nivekg/prizm-switch-control/prizm-switch-control-v1_1/prizm-switch-control-v1_1.kicad_pcb

## KiCad design prizm-switch-control-v1_1/prizm-switch-control-v1_1.kicad_pcb (2020-03-06)

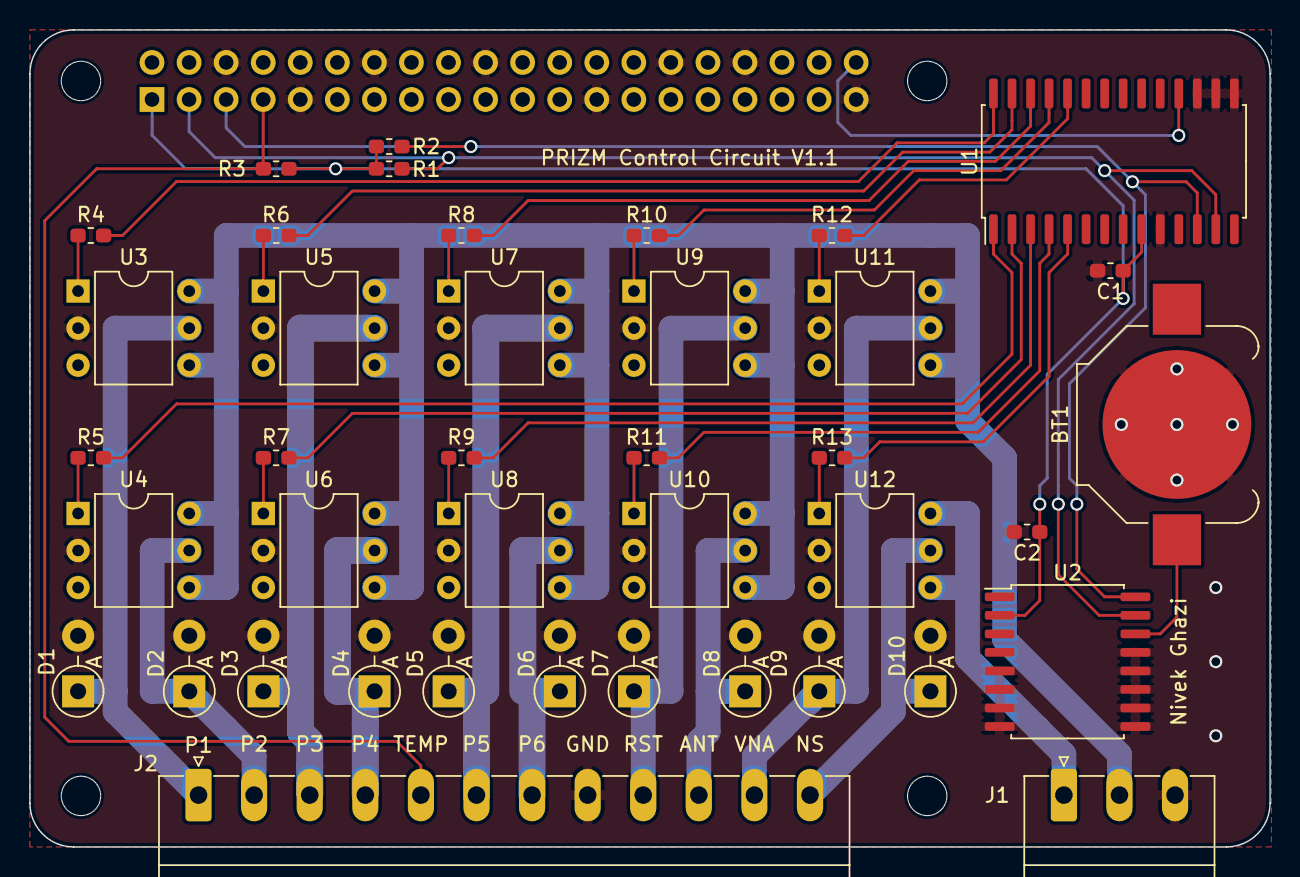
[picture p1: board prizm-switch-control-v1_1.kicad_pcb from above]

Board: 2 copper layers, 85.0 x 56.0 mm, 45 parts (1 on the bottom side), 39 nets.

Parts:
BT1: V3; BatteryHolder_Keystone_3000_1x12mm
C1: C; C_0603_1608Metric_Pad1.05x0.95mm_HandSolder
C2: 1uF; C_0603_1608Metric_Pad1.05x0.95mm_HandSolder
D1, D2, D3, D4, D5, D6, D7, D8, D9, D10: 1N4001; D_DO-41_SOD81_P3.81mm_Vertical_AnodeUp
J1: Power Connector; PhoenixContact_MC_1,5_3-G-3.81_1x03_P3.81mm_Horizontal
J2: Frontend Connector; PhoenixContact_MC_1,5_12-G-3.81_1x12_P3.81mm_Horizontal
MK1, MK2, MK3, MK4: M2.5; MountingHole_2.7mm_M2.5
P1: RPi-Header; PinSocket_2x20_P2.54mm_Vertical
R1, R2, R3: 4K7; R_0603_1608Metric_Pad1.05x0.95mm_HandSolder
R4, R5, R6, R7, R8, R9, R10, R11, R12, R13: 200; R_0603_1608Metric_Pad1.05x0.95mm_HandSolder
U1: MCP23017_SO; SOIC-28W_7.5x17.9mm_P1.27mm
U2: DS3231M; SOIC-16W_7.5x10.3mm_P1.27mm
U3, U4, U5, U6, U7, U8, U9, U10, U11, U12: TLP3543; DIP-6_W7.62mm

Connections:
+3V3: C1.1, C2.1, P1.1, R1.1, R2.1, R3.1, U1.9, U2.2
+12V: J1.2, U3.4, U3.6, U4.4, U4.6, U5.4, U5.6, U6.4, U6.6, U7.4, U7.6, U8.4, U8.6, U9.4, U9.6, U10.4, U10.6, U11.4, U11.6
+15V: J1.1, U12.4, U12.6
/i2c_expander/I2C_SCL: P1.5, R2.2, U1.12, U2.16
/i2c_expander/I2C_SDA: P1.3, R1.2, U1.13, U2.15
/i2c_expander/NOISE_ON: R13.2, U1.5
/i2c_expander/S1_POS_1: R4.2, U1.28
/i2c_expander/S1_POS_2: R5.2, U1.1
/i2c_expander/S1_POS_3: R6.2, U1.27
/i2c_expander/S1_POS_4: R7.2, U1.2
/i2c_expander/S1_POS_5: R8.2, U1.26
/i2c_expander/S1_POS_6: R9.2, U1.3
/i2c_expander/S1_RESET: R10.2, U1.25
/i2c_expander/S2_POS_1: R11.2, U1.4
/i2c_expander/S2_POS_2: R12.2, U1.24
/i2c_expander/~RESET: P1.40, U1.18
/output_connectors/ANTENNA: D8.1, J2.10, U10.5
/output_connectors/NOISE-SOURCE: D10.1, J2.12, U12.5
/output_connectors/ONE-WIRE: J2.5, P1.7, R3.2
/output_connectors/POS_1: D1.1, J2.1, U3.5
/output_connectors/POS_2: D2.1, J2.2, U4.5
/output_connectors/POS_3: D3.1, J2.3, U5.5
/output_connectors/POS_4: D4.1, J2.4, U6.5
/output_connectors/POS_5: D5.1, J2.6, U7.5
/output_connectors/POS_6: D6.1, J2.7, U8.5
/output_connectors/RESET: D7.1, J2.9, U9.5
/output_connectors/VNA: D9.1, J2.11, U11.5
/real_time_clock/3.3V_Backup: BT1.1, U2.14
GND: BT1.2, C1.2, C2.2, D1.2, D2.2, D3.2, D4.2, D5.2, D6.2, D7.2, D8.2, D9.2, D10.2, J1.3, J2.8, P1.6, P1.9, P1.14, P1.20, P1.25, P1.30, P1.34, P1.39, U1.10, U1.15, U1.16, U1.17, U2.5, U2.6, U2.7, U2.8, U2.9, U2.10, U2.11, U2.12, U2.13, U3.2, U4.2, U5.2, U6.2, U7.2, U8.2, U9.2, U10.2, U11.2, U12.2
unnamed: R4.1, U3.1
unnamed: R5.1, U4.1
unnamed: R6.1, U5.1
unnamed: R7.1, U6.1
unnamed: R8.1, U7.1
unnamed: R9.1, U8.1
unnamed: R10.1, U9.1
unnamed: R11.1, U10.1
unnamed: R12.1, U11.1
unnamed: R13.1, U12.1
