nivekg/prizm-switch-control/(commit log)

2019-06-19 Add files via upload
    New switching circuit
    [RTC.sch, Switching Circuit Design.kicad_pcb, Switching Circuit Design.sch]
2019-06-25 updated switch control schematic and partial board layout
    [RTC.sch, Switching Circuit Design.sch, switch-control-hat.kicad_pcb, switch-control-hat.sch]
2019-06-26 Add files via upload
    Updated PCB
    [switch-control-hat.kicad_pcb]
2019-06-26 Further updated PCB
    [switch-control-hat.kicad_pcb]
2019-06-27 Final board layout
    [RTC.sch, Switching Circuit Design.sch, switch-control-hat.kicad_pcb, switch-control-hat.sch]
2019-06-27 Added gerber files and names
    [switch-control-hat-B_Cu.gbl, switch-control-hat-B_Mask.gbs, switch-control-hat-B_Paste.gbp, switch-control-hat-B_SilkS.gbo, switch-control-hat-Edge_Cuts.gm1, switch-control-hat-F_Cu.gtl, switch-control-hat-F_Mask.gts, switch-control-hat-F_Paste.gtp]
2019-06-29 fixed unrouted nets and generated gerber files for fabrication
    [switch-control-hat-B_Cu.gbl, switch-control-hat-B_Mask.gbs, switch-control-hat-B_Paste.gbp, switch-control-hat-B_SilkS.gbo, switch-control-hat-Edge_Cuts.gm1, switch-control-hat-F_Cu.gtl, switch-control-hat-F_Mask.gts, switch-control-hat-F_Paste.gtp]
2019-07-02 rename gerbers.zip
2019-07-08 Fixed error where optoisolators output was connected in reverse
    [switch-control-hat-B_Cu.gbl, switch-control-hat-B_Mask.gbs, switch-control-hat-B_Paste.gbp, switch-control-hat-B_SilkS.gbo, switch-control-hat-Edge_Cuts.gm1, switch-control-hat-F_Cu.gtl, switch-control-hat-F_Mask.gts, switch-control-hat-F_Paste.gtp]
2019-07-08 generated new gerbers to take in account that optoisolator output was reversed
    [switch-control-hat-B_Cu.gbl, switch-control-hat-B_Mask.gbs, switch-control-hat-B_Paste.gbp, switch-control-hat-B_SilkS.gbo, switch-control-hat-Edge_Cuts.gm1, switch-control-hat-F_Cu.gtl, switch-control-hat-F_Mask.gts, switch-control-hat-F_Paste.gtp]
2019-09-18 Added pullup resistor for one-wire interface and changed 13 pin connector to 12 pin
    [switch-control-hat.kicad_pcb, switch-control-hat.sch]
2019-10-07 Final verision of schematic and PCB layout
    [switch-control-hat.kicad_pcb, switch-control-hat.sch]
2019-12-01 final version
    [RTC.sch, Switching Circuit Design.kicad_pcb, Switching Circuit Design.sch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]
2020-02-11 Updated to control second frontend switch
    [i2c_expander.sch, output_connectors.sch, photo_mosfets.sch, rpi.sch, rtc.sch, switch-control-hat.kicad_pcb, switch-control-hat.sch]
2020-02-11 Added connector pin labels
    [switch-control-hat.kicad_pcb]
2020-02-11 Gerber files for pcbway
    [switch-control-hat-B_Cu.gbl, switch-control-hat-B_Mask.gbs, switch-control-hat-B_SilkS.gbo, switch-control-hat-Edge_Cuts.gm1, switch-control-hat-F_Cu.gtl, switch-control-hat-F_Mask.gts, switch-control-hat-F_SilkS.gto, switch-control-hat-NPTH.drl]
2020-03-06 Fixed ERC and DRC errors
    [i2c_expander.sch, output_connectors.sch, photo_mosfets.sch, prizm-switch-control.kicad_pcb, prizm-switch-control.sch, rpi.sch, rtc.sch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]
2020-03-06 Moved all files from switch-control-hat to root
    [i2c_expander.sch, output_connectors.sch, photo_mosfets.sch, prizm-switch-control.kicad_pcb, prizm-switch-control.sch, rpi.sch, rtc.sch]
2020-03-06 Added MFN, MPN, VN and VPN fields for all symbols
    [i2c_expander.sch, output_connectors.sch, photo_mosfets.sch, prizm-switch-control.kicad_pcb, rpi.sch, rtc.sch]
2020-03-06 Moved design to its version folder
    [i2c_expander.sch, output_connectors.sch, photo_mosfets.sch, prizm-switch-control-v1_1.kicad_pcb, prizm-switch-control-v1_1.sch, rpi.sch, rtc.sch]
